partywagon112/PartyWagon112-KiCad-PCM-Repository/README.md

# kicad_repositories
A location to store my PCM files.

Use """git submodule init""" and """git submodule update""" to intialise the repository.

# Development

https://gitlab.com/kicad/libraries/kicad-library-utils
