partywagon112/PartyWagon112-KiCad-PCM-Repository/PartyWagon112-KiCad-Library/3dmodels/drafts/xt30-2.2.FCStd

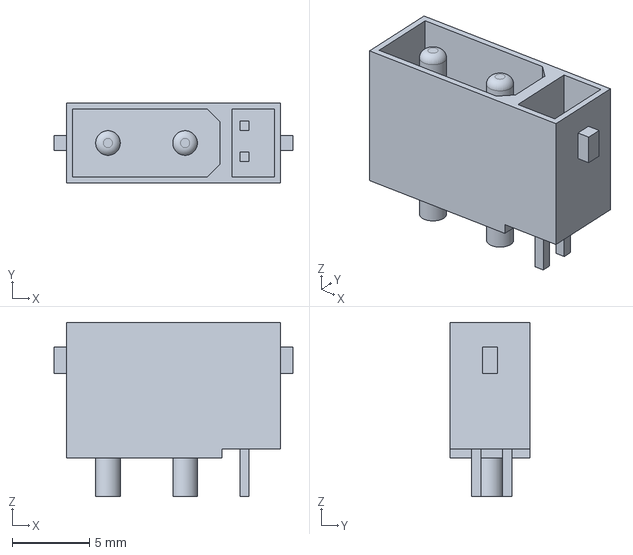
[picture p1: CAD file, 2025-12-29]
PartyWagon112-KiCad-Library/3dmodels/drafts/xt30-2.2.FCStd
15.5 x 5.20 x 11.3 mm
