partywagon112/PartyWagon112-KiCad-PCM-Repository/PartyWagon112-KiCad-Library/3dmodels/drafts/950066008000000.FCStd

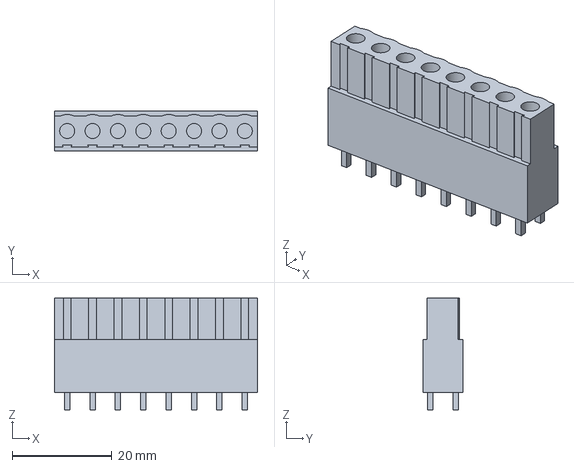
[picture p2: CAD file, 2026-08-18]
PartyWagon112-KiCad-Library/3dmodels/drafts/950066008000000.FCStd
40.6 x 8.00 x 22.4 mm
