partywagon112/PartyWagon112-KiCad-PCM-Repository/PartyWagon112-KiCad-Library/3dmodels/drafts/950066003000000-Body.step

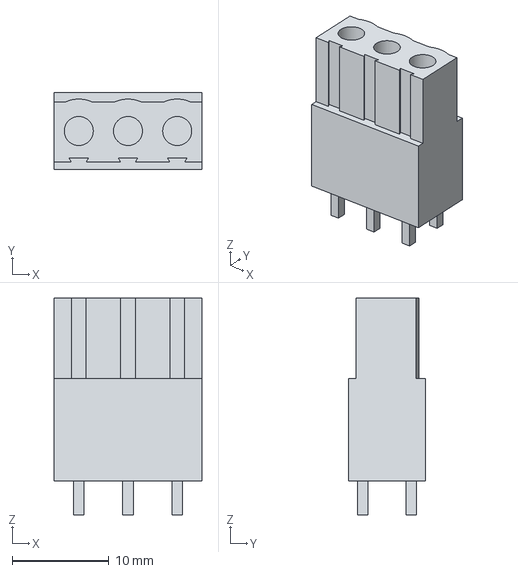
[picture p3: CAD file, 2026-08-18]
PartyWagon112-KiCad-Library/3dmodels/drafts/950066003000000-Body.step
15.2 x 8.00 x 22.4 mm
