partywagon112/PartyWagon112-KiCad-PCM-Repository/PartyWagon112-KiCad-Library/3dmodels/drafts/950066002000000.FCStd

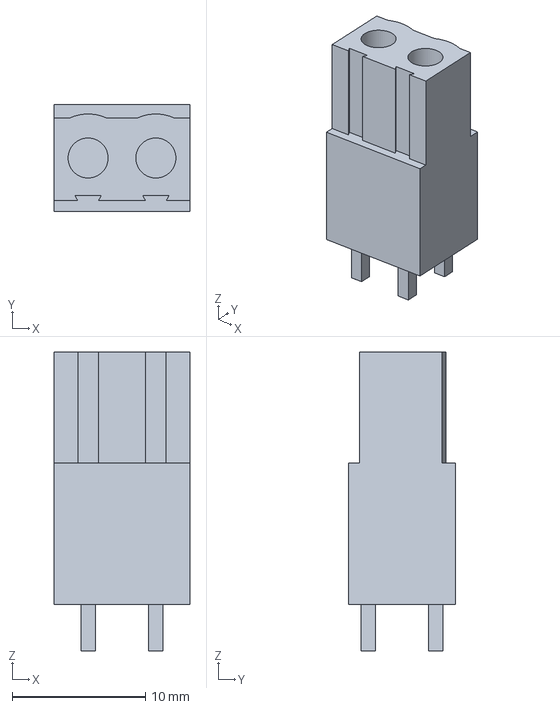
[picture p4: CAD file, 2026-06-24]
PartyWagon112-KiCad-Library/3dmodels/drafts/950066002000000.FCStd
10.2 x 8.00 x 22.4 mm
