partywagon112/PartyWagon112-KiCad-PCM-Repository/(list of files, cad)

Other CAD files:
PartyWagon112-KiCad-Library/3dmodels/drafts/950066003000000.FCStd
PartyWagon112-KiCad-Library/3dmodels/drafts/950066008000000-Body.step
PartyWagon112-KiCad-Library/3dmodels/drafts/950066002000000-Body.step
