partywagon112/PartyWagon112-KiCad-PCM-Repository/(commit log)

2025-02-12 Added DFN1010-3
    [Library_Management_Project.kicad_pcb, Library_Management_Project.kicad_sch]
2025-04-13 Added ethernet switch
2025-04-15 Fixed ethernet switch symbol again
2025-04-20 added templates
    [Expansion_Card.kicad_pcb, Expansion_Card.sch]
2025-04-26 Updated switch footprint to use kicad diff pair conventions
2025-05-04 Updated KSZ9897R symbol with easier pin scheme
2025-06-01 Added PG_TSDSON_8 footprint
2025-06-08 added TPS65265RHBR regulator
2025-06-08 created more space to bst pin
2025-06-26 Revision to switch
2025-06-26 Added CM5 and updated M.2 footprint
2025-08-06 Added new ZIF connector
2025-09-30 Updated footprint
2025-12-29 added step files for crapnectors
    [xt30-2.2.FCStd]
2026-03-02 Added ESP32-C6 symbol
2026-06-01 fixed first pin
2026-06-24 Added some pluggable terminals
    [950066002000000-Body.step, 950066002000000.FCStd, 950066008000000-Body.step, 950066008000000.FCStd]
2026-07-08 Added ST_DFN-12-L_3x3mm and charger
2026-07-21 fixed footprint name
2026-08-18 Added 3 pin pluggable terminal
    [950066003000000-Body.step, 950066003000000.FCStd, 950066008000000.FCStd]
2026-08-19 Added snaptron footprint
2026-08-19 Added another switch
2026-09-21 Added reverse mount led
2026-09-30 Added esp32-h2
